coaic/Minimal-UART-Computer-3/(list of files, drawings)

Other design files:
KiCAD10/8-Bit CPU 32k.dsn
