coaic/Minimal-UART-Computer-3/KiCAD10/8-Bit CPU 32k.kicad_pcb

## KiCad design KiCAD10/8-Bit CPU 32k.kicad_pcb (2026-06-27)

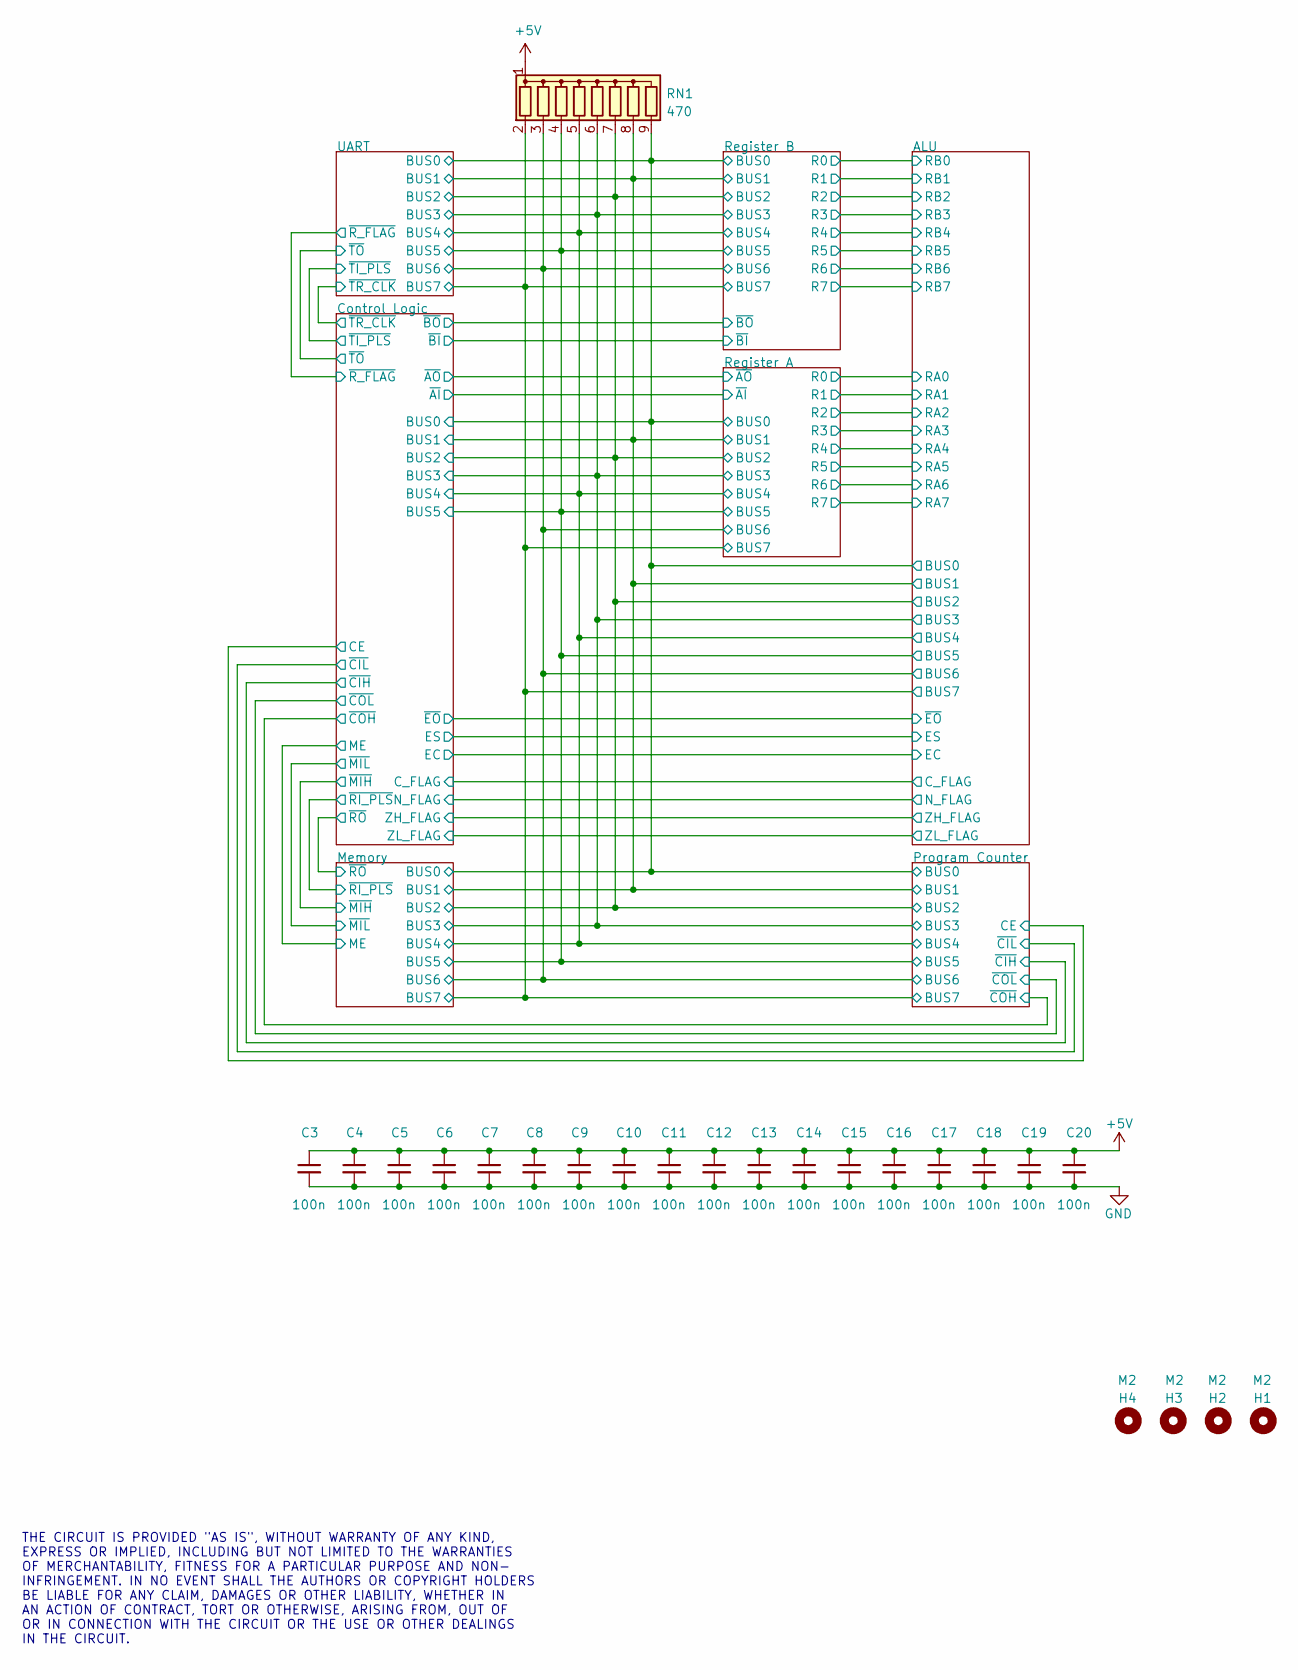
[picture p1: schematic 8-Bit CPU 32k.kicad_sch, Minimal UART Computer 3]

Parts:
C3, C4, C5, C6, C7, C8, C9, C10, C11, C12, C13, C14, C15, C16, C17, C18, C19, C20: 100n; C_Disc_D3.0mm_W2.0mm_P2.50mm
H1, H2, H3, H4: M2; MountingHole_2.2mm_M2
RN1: 470; R_Array_SIP9

Connections:
+5V: C3.1, C4.1, C5.1, C6.1, C7.1, C8.1, C9.1, C10.1, C11.1, C12.1, C13.1, C14.1, C15.1, C16.1, C17.1, C18.1, C19.1, C20.1, RN1.1 (common); also elsewhere on the board
/ALU/BUS0: RN1.9 (R8); also elsewhere on the board
/ALU/BUS1: RN1.8 (R7); also elsewhere on the board
/ALU/BUS2: RN1.7 (R6); also elsewhere on the board
/ALU/BUS3: RN1.6 (R5); also elsewhere on the board
/ALU/BUS4: RN1.5 (R4); also elsewhere on the board
/ALU/BUS5: RN1.4 (R3); also elsewhere on the board
/ALU/BUS6: RN1.3 (R2); also elsewhere on the board
/ALU/BUS7: RN1.2 (R1); also elsewhere on the board
GND: C3.2, C4.2, C5.2, C6.2, C7.2, C8.2, C9.2, C10.2, C11.2, C12.2, C13.2, C14.2, C15.2, C16.2, C17.2, C18.2, C19.2, C20.2; also elsewhere on the board

Notes on the sheet:
THE CIRCUIT IS PROVIDED "AS IS", WITHOUT WARRANTY OF ANY KIND, EXPRESS OR IMPLIED, INCLUDING BUT NOT LIMITED TO THE WARRANTIES OF MERCHANTABILITY, FITNESS FOR A PARTICULAR PURPOSE AND NON- INFRINGEMENT. IN NO EVENT SHALL THE AUTHORS OR COPYRIGHT HOLDERS BE LIABLE FOR ANY CLAIM, DAMAGES OR OTHER LIA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

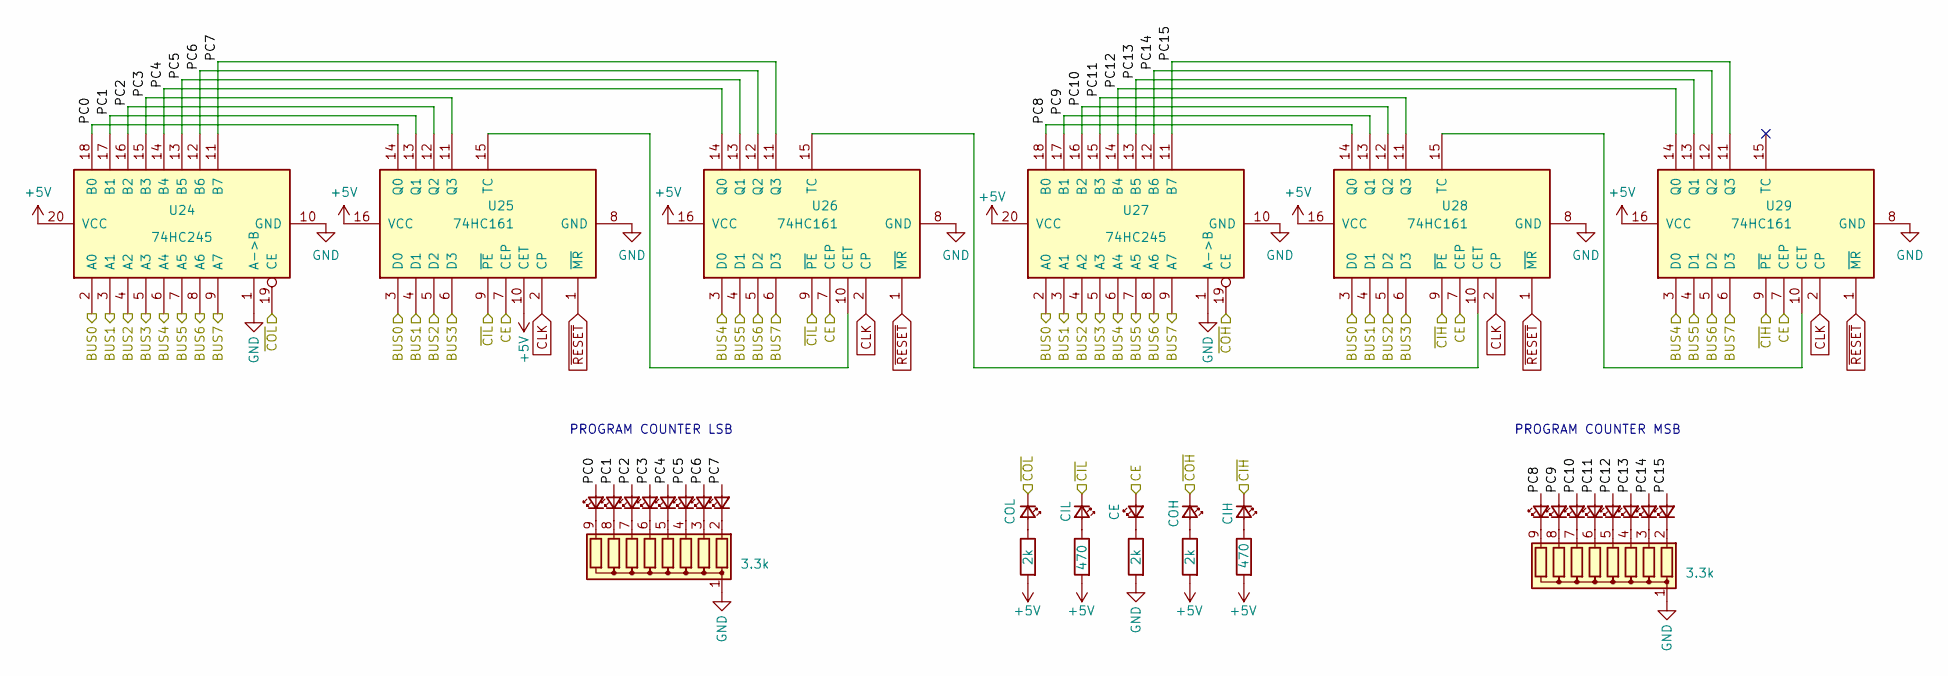
[picture p2: schematic PC.kicad_sch, Program Counter]

Parts:
D20, D21, D22, D23, D24, D25, D26, D27, D28, D29, D30, D31, D32, D33, D34, D35: LED_Small; LED_D5.0mm
D79: CIH; LED_D5.0mm
D81: COH; LED_D5.0mm
D83: COL; LED_D5.0mm
D84: CIL; LED_D5.0mm
D92: CE; LED_D5.0mm
R12, R17: 470; R_Axial_DIN0207_L6.3mm_D2.5mm_P7.62mm_Horizontal
R14, R16, R25: 2k; R_Axial_DIN0207_L6.3mm_D2.5mm_P7.62mm_Horizontal
RN4, RN5: 3.3k; R_Array_SIP9
U24, U27: 74HC245; DIP-20_W7.62mm
U25, U26, U28, U29: 74HC161; DIP-16_W7.62mm

Connections:
+5V: R12.2, R14.2, R16.2, R17.2, U24.20 (VCC), U25.10 (CET), U25.16 (VCC), U26.16 (VCC), U27.20 (VCC), U28.16 (VCC), U29.16 (VCC); also elsewhere on the board
/ALU/BUS0: U24.2 (A0), U25.3 (D0), U27.2 (A0), U28.3 (D0); also elsewhere on the board
/ALU/BUS1: U24.3 (A1), U25.4 (D1), U27.3 (A1), U28.4 (D1); also elsewhere on the board
/ALU/BUS2: U24.4 (A2), U25.5 (D2), U27.4 (A2), U28.5 (D2); also elsewhere on the board
/ALU/BUS3: U24.5 (A3), U25.6 (D3), U27.5 (A3), U28.6 (D3); also elsewhere on the board
/ALU/BUS4: U24.6 (A4), U26.3 (D0), U27.6 (A4), U29.3 (D0); also elsewhere on the board
/ALU/BUS5: U24.7 (A5), U26.4 (D1), U27.7 (A5), U29.4 (D1); also elsewhere on the board
/ALU/BUS6: U24.8 (A6), U26.5 (D2), U27.8 (A6), U29.5 (D2); also elsewhere on the board
/ALU/BUS7: U24.9 (A7), U26.6 (D3), U27.9 (A7), U29.6 (D3); also elsewhere on the board
/Control Logic/CE: D92.2 (A), U25.7 (CEP), U26.7 (CEP), U28.7 (CEP), U29.7 (CEP); also elsewhere on the board
/Control Logic/~CIH: D79.1 (K), U28.9 (~PE), U29.9 (~PE); also elsewhere on the board
/Control Logic/~CIL: D84.1 (K), U25.9 (~PE), U26.9 (~PE); also elsewhere on the board
/Control Logic/~COH: D81.1 (K), U27.19 (CE); also elsewhere on the board
/Control Logic/~COL: D83.1 (K), U24.19 (CE); also elsewhere on the board
/Program Counter/PC0: D20.2 (A), U24.18 (B0), U25.14 (Q0)
/Program Counter/PC1: D21.2 (A), U24.17 (B1), U25.13 (Q1)
/Program Counter/PC2: D22.2 (A), U24.16 (B2), U25.12 (Q2)
/Program Counter/PC3: D23.2 (A), U24.15 (B3), U25.11 (Q3)
/Program Counter/PC4: D24.2 (A), U24.14 (B4), U26.14 (Q0)
/Program Counter/PC5: D25.2 (A), U24.13 (B5), U26.13 (Q1)
/Program Counter/PC6: D26.2 (A), U24.12 (B6), U26.12 (Q2)
/Program Counter/PC7: D27.2 (A), U24.11 (B7), U26.11 (Q3)
/Program Counter/PC8: D28.2 (A), U27.18 (B0), U28.14 (Q0)
/Program Counter/PC9: D29.2 (A), U27.17 (B1), U28.13 (Q1)
/Program Counter/PC10: D30.2 (A), U27.16 (B2), U28.12 (Q2)
/Program Counter/PC11: D31.2 (A), U27.15 (B3), U28.11 (Q3)
/Program Counter/PC12: D32.2 (A), U27.14 (B4), U29.14 (Q0)
/Program Counter/PC13: D33.2 (A), U27.13 (B5), U29.13 (Q1)
/Program Counter/PC14: D34.2 (A), U27.12 (B6), U29.12 (Q2)
/Program Counter/PC15: D35.2 (A), U27.11 (B7), U29.11 (Q3)
CLK: U25.2 (CP), U26.2 (CP), U28.2 (CP), U29.2 (CP); also elsewhere on the board
GND: R25.2, RN4.1 (common), RN5.1 (common), U24.1 (A->B), U24.10 (GND), U25.8 (GND), U26.8 (GND), U27.1 (A->B), U27.10 (GND), U28.8 (GND), U29.8 (GND); also elsewhere on the board
unnamed: D20.1 (K), RN4.9 (R8)
unnamed: D21.1 (K), RN4.8 (R7)
unnamed: D22.1 (K), RN4.7 (R6)
unnamed: D23.1 (K), RN4.6 (R5)
unnamed: D24.1 (K), RN4.5 (R4)
unnamed: D25.1 (K), RN4.4 (R3)
unnamed: D26.1 (K), RN4.3 (R2)
unnamed: D27.1 (K), RN4.2 (R1)
unnamed: D28.1 (K), RN5.9 (R8)
unnamed: D29.1 (K), RN5.8 (R7)
unnamed: D30.1 (K), RN5.7 (R6)
unnamed: D31.1 (K), RN5.6 (R5)
unnamed: D32.1 (K), RN5.5 (R4)
unnamed: D33.1 (K), RN5.4 (R3)
unnamed: D34.1 (K), RN5.3 (R2)
unnamed: D35.1 (K), RN5.2 (R1)
unnamed: D79.2 (A), R12.1
unnamed: D81.2 (A), R14.1
unnamed: D83.2 (A), R16.1
unnamed: D84.2 (A), R17.1
unnamed: D92.1 (K), R25.1
unnamed: U25.15 (TC), U26.10 (CET)
unnamed: U26.15 (TC), U28.10 (CET)
unnamed: U28.15 (TC), U29.10 (CET)
~RESET: U25.1 (~MR), U26.1 (~MR), U28.1 (~MR), U29.1 (~MR); also elsewhere on the board

Notes on the sheet:
PROGRAM COUNTER MSB
PROGRAM COUNTER LSB

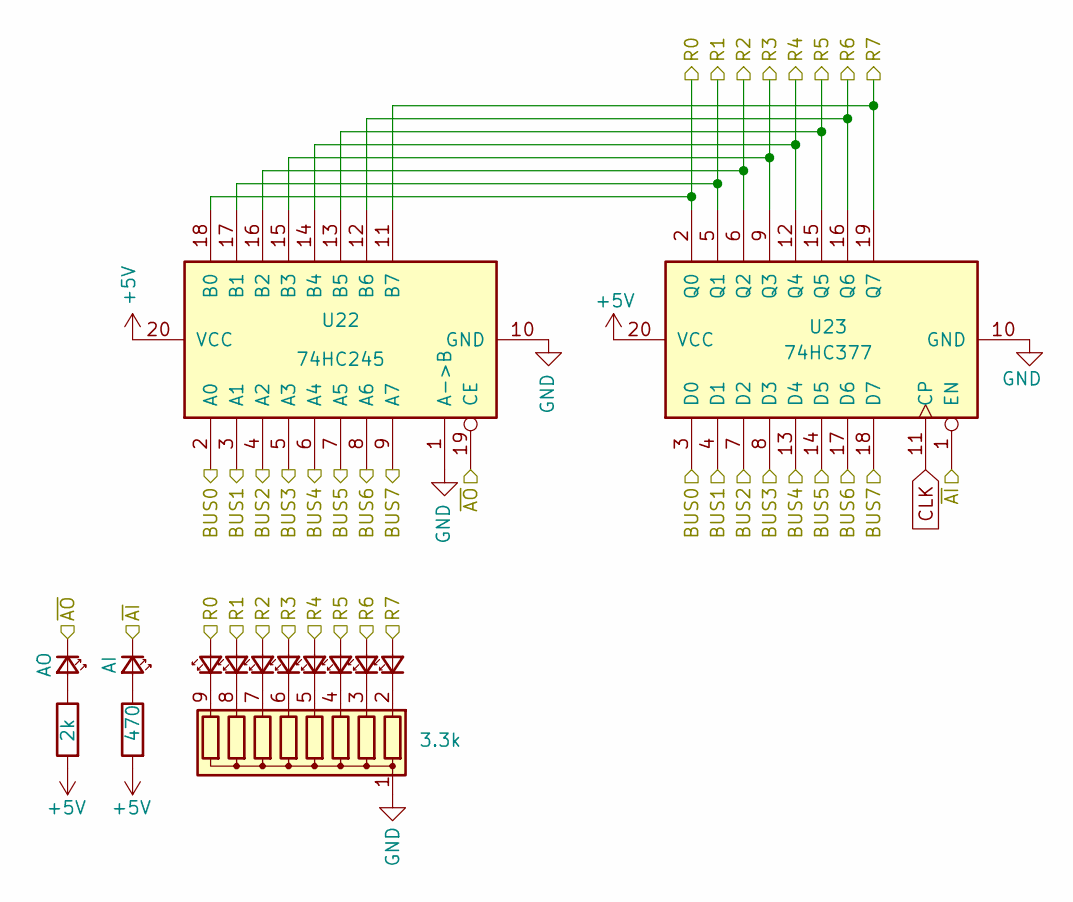
[picture p3: schematic RegA.kicad_sch, A Register]

Parts:
D36, D37, D38, D39, D40, D41, D42, D43: LED_Small; LED_D5.0mm
D65: AI; LED_D5.0mm
D66: AO; LED_D5.0mm
R7: 470; R_Axial_DIN0207_L6.3mm_D2.5mm_P7.62mm_Horizontal
R8: 2k; R_Axial_DIN0207_L6.3mm_D2.5mm_P7.62mm_Horizontal
RN6: 3.3k; R_Array_SIP9
U22: 74HC245; DIP-20_W7.62mm
U23: 74HC377; DIP-20_W7.62mm

Connections:
+5V: R7.2, R8.2, U22.20 (VCC), U23.20 (VCC); also elsewhere on the board
/ALU/BUS0: U22.2 (A0), U23.3 (D0); also elsewhere on the board
/ALU/BUS1: U22.3 (A1), U23.4 (D1); also elsewhere on the board
/ALU/BUS2: U22.4 (A2), U23.7 (D2); also elsewhere on the board
/ALU/BUS3: U22.5 (A3), U23.8 (D3); also elsewhere on the board
/ALU/BUS4: U22.6 (A4), U23.13 (D4); also elsewhere on the board
/ALU/BUS5: U22.7 (A5), U23.14 (D5); also elsewhere on the board
/ALU/BUS6: U22.8 (A6), U23.17 (D6); also elsewhere on the board
/ALU/BUS7: U22.9 (A7), U23.18 (D7); also elsewhere on the board
/ALU/RA0: D36.2 (A), U22.18 (B0), U23.2 (Q0); also elsewhere on the board
/ALU/RA1: D37.2 (A), U22.17 (B1), U23.5 (Q1); also elsewhere on the board
/ALU/RA2: D38.2 (A), U22.16 (B2), U23.6 (Q2); also elsewhere on the board
/ALU/RA3: D39.2 (A), U22.15 (B3), U23.9 (Q3); also elsewhere on the board
/ALU/RA4: D40.2 (A), U22.14 (B4), U23.12 (Q4); also elsewhere on the board
/ALU/RA5: D41.2 (A), U22.13 (B5), U23.15 (Q5); also elsewhere on the board
/ALU/RA6: D42.2 (A), U22.12 (B6), U23.16 (Q6); also elsewhere on the board
/ALU/RA7: D43.2 (A), U22.11 (B7), U23.19 (Q7); also elsewhere on the board
/Control Logic/~AI: D65.1 (K), U23.1 (EN); also elsewhere on the board
/Control Logic/~AO: D66.1 (K), U22.19 (CE); also elsewhere on the board
CLK: U23.11 (CP); also elsewhere on the board
GND: RN6.1 (common), U22.1 (A->B), U22.10 (GND), U23.10 (GND); also elsewhere on the board
unnamed: D36.1 (K), RN6.9 (R8)
unnamed: D37.1 (K), RN6.8 (R7)
unnamed: D38.1 (K), RN6.7 (R6)
unnamed: D39.1 (K), RN6.6 (R5)
unnamed: D40.1 (K), RN6.5 (R4)
unnamed: D41.1 (K), RN6.4 (R3)
unnamed: D42.1 (K), RN6.3 (R2)
unnamed: D43.1 (K), RN6.2 (R1)
unnamed: D65.2 (A), R7.1
unnamed: D66.2 (A), R8.1

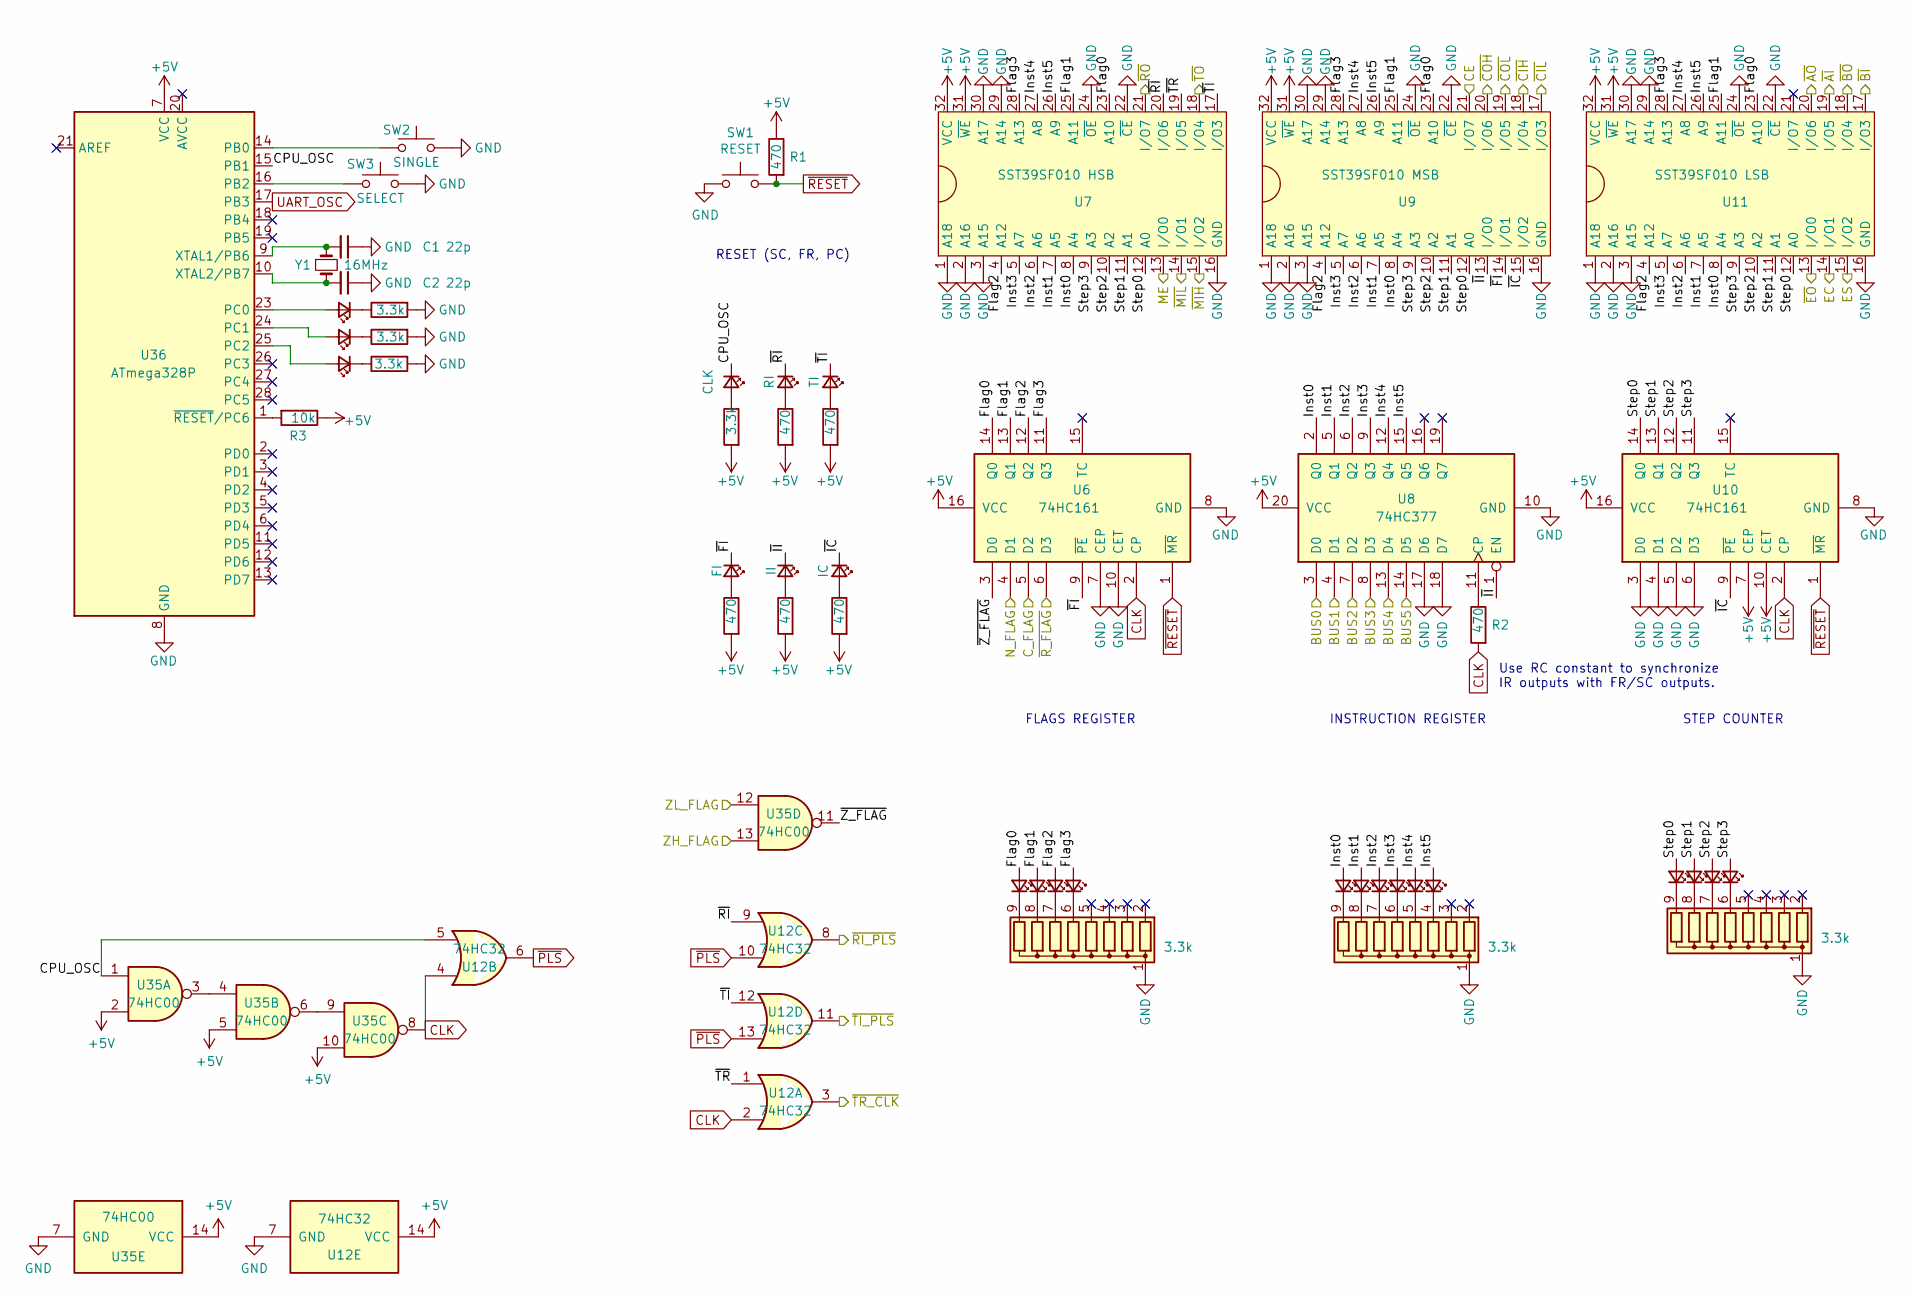
[picture p4: schematic IR.kicad_sch, Control Logic]

Parts:
C1, C2: 22p; C_Disc_D5.0mm_W2.5mm_P2.50mm
D1, D2, D3: LED_small; LED_D5.0mm
D60, D61, D62, D63, D64, D67, D68, D69, D70, D71, D72, D73, D74, D75: LED_Small; LED_D5.0mm
D82: RI; LED_D5.0mm
D87: TI; LED_D5.0mm
D89: FI; LED_D5.0mm
D90: II; LED_D5.0mm
D91: IC; LED_D5.0mm
D100: CLK; LED_D5.0mm
R1, R2, R15, R20, R22, R23, R24: 470; R_Axial_DIN0207_L6.3mm_D2.5mm_P7.62mm_Horizontal
R3: 10k; R_Axial_DIN0207_L6.3mm_D2.5mm_P7.62mm_Horizontal
R4, R5, R6, R33: 3.3k; R_Axial_DIN0207_L6.3mm_D2.5mm_P7.62mm_Horizontal
RN9, RN10, RN11: 3.3k; R_Array_SIP9
SW1: RESET; SW_PUSH_6mm
SW2: SINGLE; SW_PUSH_6mm
SW3: SELECT; SW_PUSH_6mm
U6, U10: 74HC161; DIP-16_W7.62mm
U7: SST39SF010 HSB; DIP-32_W15.24mm
U8: 74HC377; DIP-20_W7.62mm
U9: SST39SF010 MSB; DIP-32_W15.24mm
U11: SST39SF010 LSB; DIP-32_W15.24mm
U12: 74HC32; DIP-14_W7.62mm
U35: 74HC00; DIP-14_W7.62mm
U36: ATmega328P; DIP-28_W7.62mm
Y1: 16MHz; Crystal_HC18-U_Vertical

Connections:
+5V: R1.1, R3.1, R15.2, R20.2, R22.2, R23.2, R24.2, R33.2, U6.16 (VCC), U7.31 (~WE), U7.32 (VCC), U8.20 (VCC), U9.31 (~WE), U9.32 (VCC), U10.7 (CEP), U10.10 (CET), U10.16 (VCC), U11.31 (~WE), U11.32 (VCC), U12.14 (VCC), U35.2, U35.5, U35.10, U35.14 (VCC), U36.7 (VCC); also elsewhere on the board
/ALU/BUS0: U8.3 (D0); also elsewhere on the board
/ALU/BUS1: U8.4 (D1); also elsewhere on the board
/ALU/BUS2: U8.7 (D2); also elsewhere on the board
/ALU/BUS3: U8.8 (D3); also elsewhere on the board
/ALU/BUS4: U8.13 (D4); also elsewhere on the board
/ALU/BUS5: U8.14 (D5); also elsewhere on the board
/ALU/C_FLAG: U6.5 (D2); also elsewhere on the board
/ALU/EC: U11.14 (I/O1); also elsewhere on the board
/ALU/ES: U11.15 (I/O2); also elsewhere on the board
/ALU/N_FLAG: U6.4 (D1); also elsewhere on the board
/ALU/ZH_FLAG: U35.13; also elsewhere on the board
/ALU/ZL_FLAG: U35.12; also elsewhere on the board
/ALU/~EO: U11.13 (I/O0); also elsewhere on the board
/Control Logic/CE: U9.21 (I/O7); also elsewhere on the board
/Control Logic/CPU_OSC: D100.1 (K), U12.5, U35.1, U36.15 (PB1)
/Control Logic/Flag0: D71.2 (A), U6.14 (Q0), U7.23 (A10), U9.23 (A10), U11.23 (A10)
/Control Logic/Flag1: D70.2 (A), U6.13 (Q1), U7.25 (A11), U9.25 (A11), U11.25 (A11)
/Control Logic/Flag2: D69.2 (A), U6.12 (Q2), U7.4 (A12), U9.4 (A12), U11.4 (A12)
/Control Logic/Flag3: D68.2 (A), U6.11 (Q3), U7.28 (A13), U9.28 (A13), U11.28 (A13)
/Control Logic/Inst0: D63.2 (A), U7.8 (A4), U8.2 (Q0), U9.8 (A4), U11.8 (A4)
/Control Logic/Inst1: D62.2 (A), U7.7 (A5), U8.5 (Q1), U9.7 (A5), U11.7 (A5)
/Control Logic/Inst2: D61.2 (A), U7.6 (A6), U8.6 (Q2), U9.6 (A6), U11.6 (A6)
/Control Logic/Inst3: D60.2 (A), U7.5 (A7), U8.9 (Q3), U9.5 (A7), U11.5 (A7)
/Control Logic/Inst4: D64.2 (A), U7.27 (A8), U8.12 (Q4), U9.27 (A8), U11.27 (A8)
/Control Logic/Inst5: D67.2 (A), U7.26 (A9), U8.15 (Q5), U9.26 (A9), U11.26 (A9)
/Control Logic/ME: U7.13 (I/O0); also elsewhere on the board
/Control Logic/Step0: D75.2 (A), U7.12 (A0), U9.12 (A0), U10.14 (Q0), U11.12 (A0)
/Control Logic/Step1: D74.2 (A), U7.11 (A1), U9.11 (A1), U10.13 (Q1), U11.11 (A1)
/Control Logic/Step2: D73.2 (A), U7.10 (A2), U9.10 (A2), U10.12 (Q2), U11.10 (A2)
/Control Logic/Step3: D72.2 (A), U7.9 (A3), U9.9 (A3), U10.11 (Q3), U11.9 (A3)
/Control Logic/~AI: U11.19 (I/O5); also elsewhere on the board
/Control Logic/~AO: U11.20 (I/O6); also elsewhere on the board
/Control Logic/~BI: U11.17 (I/O3); also elsewhere on the board
/Control Logic/~BO: U11.18 (I/O4); also elsewhere on the board
/Control Logic/~CIH: U9.18 (I/O4); also elsewhere on the board
/Control Logic/~CIL: U9.17 (I/O3); also elsewhere on the board
/Control Logic/~COH: U9.20 (I/O6); also elsewhere on the board
/Control Logic/~COL: U9.19 (I/O5); also elsewhere on the board
/Control Logic/~FI: D89.1 (K), U6.9 (~PE), U9.14 (I/O1)
/Control Logic/~IC: D91.1 (K), U9.15 (I/O2), U10.9 (~PE)
/Control Logic/~II: D90.1 (K), U8.1 (EN), U9.13 (I/O0)
/Control Logic/~MIH: U7.15 (I/O2); also elsewhere on the board
/Control Logic/~MIL: U7.14 (I/O1); also elsewhere on the board
/Control Logic/~RI_PLS: U12.8; also elsewhere on the board
/Control Logic/~RI: D82.1 (K), U7.20 (I/O6), U12.9
/Control Logic/~RO: U7.21 (I/O7); also elsewhere on the board
/Control Logic/~R_FLAG: U6.6 (D3); also elsewhere on the board
/Control Logic/~TI_PLS: U12.11; also elsewhere on the board
/Control Logic/~TI: D87.1 (K), U7.17 (I/O3), U12.12
/Control Logic/~TO: U7.18 (I/O4); also elsewhere on the board
/Control Logic/~TR_PLS: U12.3; also elsewhere on the board
/Control Logic/~TR: U7.19 (I/O5), U12.1
/Control Logic/~Z_FLAG: U6.3 (D0), U35.11
CLK: R2.2, U6.2 (CP), U10.2 (CP), U12.2, U12.4, U35.8; also elsewhere on the board
GND: C1.1, C2.1, R4.2, R5.2, R6.2, RN9.1 (common), RN10.1 (common), RN11.1 (common), SW1.2, SW2.1, SW3.1, U6.7 (CEP), U6.8 (GND), U6.10 (CET), U7.1 (A18), U7.2 (A16), U7.3 (A15), U7.16 (GND), U7.22 (~CE), U7.24 (~OE), U7.29 (A14), U7.30 (A17), U8.10 (GND), U8.17 (D6), U8.18 (D7), U9.1 (A18), U9.2 (A16), U9.3 (A15), U9.16 (GND), U9.22 (~CE), U9.24 (~OE), U9.29 (A14), U9.30 (A17), U10.3 (D0), U10.4 (D1), U10.5 (D2), U10.6 (D3), U10.8 (GND), U11.1 (A18), U11.2 (A16), U11.3 (A15), U11.16 (GND), U11.22 (~CE), U11.24 (~OE), U11.29 (A14), U11.30 (A17), U12.7 (GND), U35.7 (GND), U36.8 (GND), U36.22 (GND); also elsewhere on the board
unnamed: D1.2 (A), U36.25 (PC2)
unnamed: D1.1 (K), R4.1
unnamed: D2.2 (A), U36.24 (PC1)
unnamed: D2.1 (K), R5.1
unnamed: D3.2 (A), U36.23 (PC0)
unnamed: D3.1 (K), R6.1
unnamed: D60.1 (K), RN9.6 (R5)
unnamed: D61.1 (K), RN9.7 (R6)
unnamed: D62.1 (K), RN9.8 (R7)
unnamed: D63.1 (K), RN9.9 (R8)
unnamed: D64.1 (K), RN9.5 (R4)
unnamed: D67.1 (K), RN9.4 (R3)
unnamed: D68.1 (K), RN11.6 (R5)
unnamed: D69.1 (K), RN11.7 (R6)
unnamed: D70.1 (K), RN11.8 (R7)
unnamed: D71.1 (K), RN11.9 (R8)
unnamed: D72.1 (K), RN10.6 (R5)
unnamed: D73.1 (K), RN10.7 (R6)
unnamed: D74.1 (K), RN10.8 (R7)
unnamed: D75.1 (K), RN10.9 (R8)
unnamed: D82.2 (A), R15.1
unnamed: D87.2 (A), R20.1
unnamed: D89.2 (A), R22.1
unnamed: D90.2 (A), R23.1
unnamed: D91.2 (A), R24.1
unnamed: D100.2 (A), R33.1
unnamed: R2.1, U8.11 (CP)
unnamed: U35.3, U35.4
unnamed: U35.6, U35.9
unnamed: SW2.2, U36.14 (PB0)
unnamed: SW3.2, U36.16 (PB2)
unnamed: C1.2, U36.9 (XTAL1/PB6), Y1.1
unnamed: C2.2, U36.10 (XTAL2/PB7), Y1.2
unnamed: R3.2, U36.1 (~RESET/PC6)
UART_OSC: U36.17 (PB3); also elsewhere on the board
~PLS: U12.6, U12.10, U12.13; also elsewhere on the board
~RESET: R1.2, SW1.1, U6.1 (~MR), U10.1 (~MR); also elsewhere on the board

Notes on the sheet:
INSTRUCTION REGISTER
RESET (SC, FR, PC)
STEP COUNTER
FLAGS REGISTER
Use RC constant to synchronize IR outputs with FR/SC outputs.

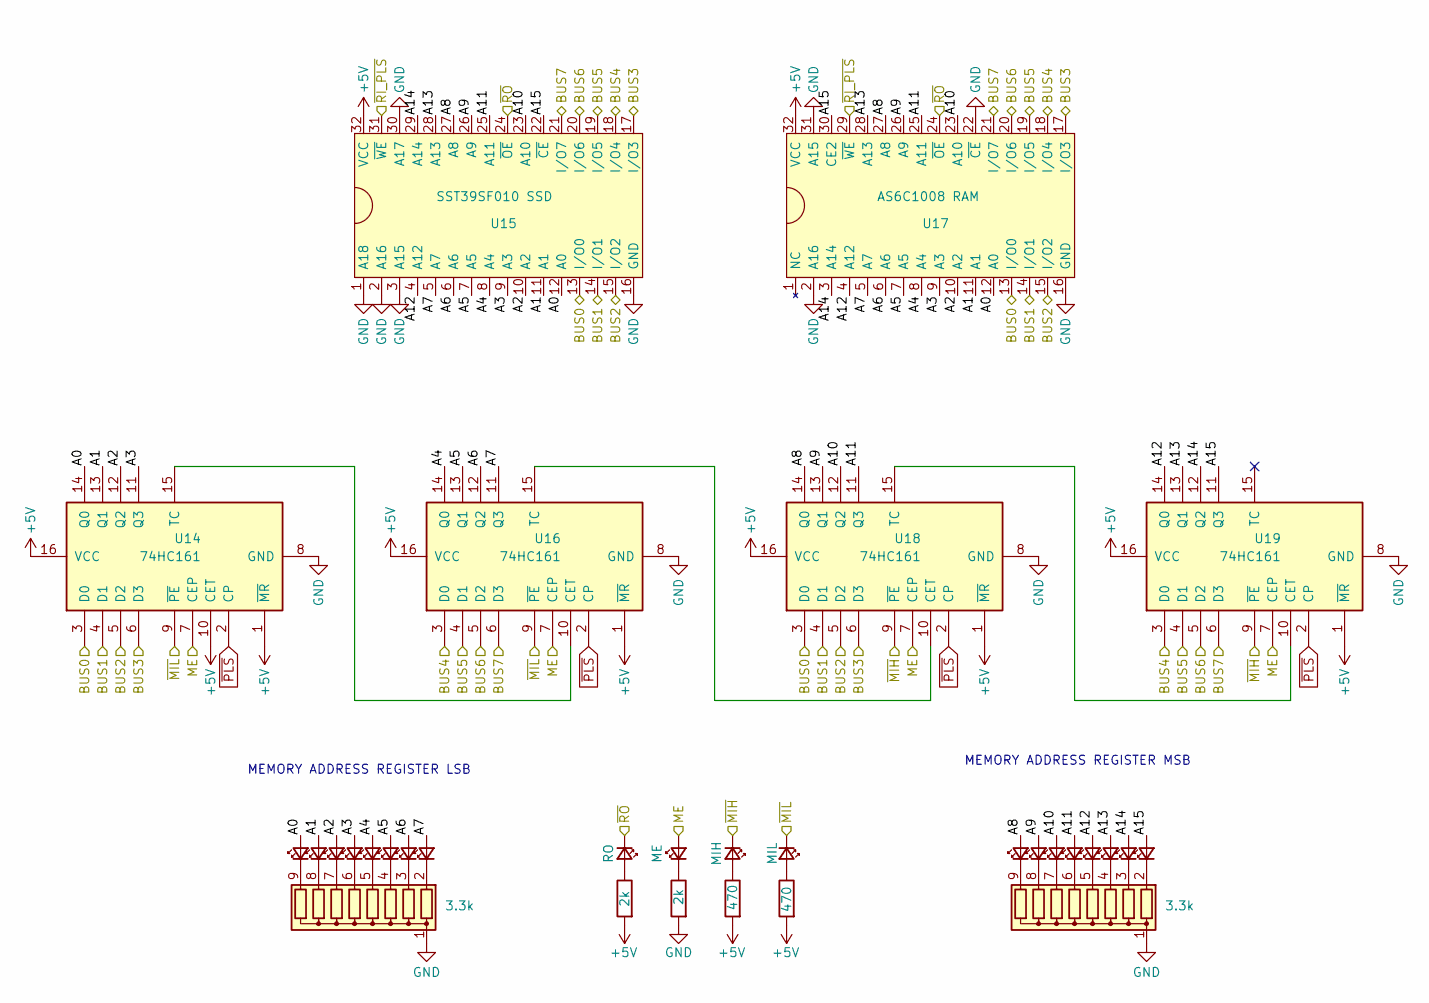
[picture p5: schematic RAM.kicad_sch, RAM, ROM and MAR]

Parts:
D4, D5, D6, D7, D8, D9, D10, D11, D12, D13, D14, D15, D16, D17, D18, D19: LED_Small; LED_D5.0mm
D85: MIL; LED_D5.0mm
D86: MIH; LED_D5.0mm
D88: ME; LED_D5.0mm
D99: RO; LED_D5.0mm
R18, R19: 470; R_Axial_DIN0207_L6.3mm_D2.5mm_P7.62mm_Horizontal
R21, R32: 2k; R_Axial_DIN0207_L6.3mm_D2.5mm_P7.62mm_Horizontal
RN2, RN3: 3.3k; R_Array_SIP9
U14, U16, U18, U19: 74HC161; DIP-16_W7.62mm
U15: SST39SF010 SSD; DIP-32_W15.24mm
U17: AS6C1008 RAM; DIP-32_W15.24mm

Connections:
+5V: R18.2, R19.2, R32.2, U14.1 (~MR), U14.10 (CET), U14.16 (VCC), U15.32 (VCC), U16.1 (~MR), U16.16 (VCC), U17.32 (VCC), U18.1 (~MR), U18.16 (VCC), U19.1 (~MR), U19.16 (VCC); also elsewhere on the board
/ALU/BUS0: U14.3 (D0), U15.13 (I/O0), U17.13 (I/O0), U18.3 (D0); also elsewhere on the board
/ALU/BUS1: U14.4 (D1), U15.14 (I/O1), U17.14 (I/O1), U18.4 (D1); also elsewhere on the board
/ALU/BUS2: U14.5 (D2), U15.15 (I/O2), U17.15 (I/O2), U18.5 (D2); also elsewhere on the board
/ALU/BUS3: U14.6 (D3), U15.17 (I/O3), U17.17 (I/O3), U18.6 (D3); also elsewhere on the board
/ALU/BUS4: U15.18 (I/O4), U16.3 (D0), U17.18 (I/O4), U19.3 (D0); also elsewhere on the board
/ALU/BUS5: U15.19 (I/O5), U16.4 (D1), U17.19 (I/O5), U19.4 (D1); also elsewhere on the board
/ALU/BUS6: U15.20 (I/O6), U16.5 (D2), U17.20 (I/O6), U19.5 (D2); also elsewhere on the board
/ALU/BUS7: U15.21 (I/O7), U16.6 (D3), U17.21 (I/O7), U19.6 (D3); also elsewhere on the board
/Control Logic/ME: D88.2 (A), U14.7 (CEP), U16.7 (CEP), U18.7 (CEP), U19.7 (CEP); also elsewhere on the board
/Control Logic/~MIH: D86.1 (K), U18.9 (~PE), U19.9 (~PE); also elsewhere on the board
/Control Logic/~MIL: D85.1 (K), U14.9 (~PE), U16.9 (~PE); also elsewhere on the board
/Control Logic/~RI_PLS: U15.31 (~WE), U17.29 (~WE); also elsewhere on the board
/Control Logic/~RO: D99.1 (K), U15.24 (~OE), U17.24 (~OE); also elsewhere on the board
/Memory/A0: D7.2 (A), U14.14 (Q0), U15.12 (A0), U17.12 (A0)
/Memory/A1: D6.2 (A), U14.13 (Q1), U15.11 (A1), U17.11 (A1)
/Memory/A2: D5.2 (A), U14.12 (Q2), U15.10 (A2), U17.10 (A2)
/Memory/A3: D4.2 (A), U14.11 (Q3), U15.9 (A3), U17.9 (A3)
/Memory/A4: D11.2 (A), U15.8 (A4), U16.14 (Q0), U17.8 (A4)
/Memory/A5: D10.2 (A), U15.7 (A5), U16.13 (Q1), U17.7 (A5)
/Memory/A6: D9.2 (A), U15.6 (A6), U16.12 (Q2), U17.6 (A6)
/Memory/A7: D8.2 (A), U15.5 (A7), U16.11 (Q3), U17.5 (A7)
/Memory/A8: D12.2 (A), U15.27 (A8), U17.27 (A8), U18.14 (Q0)
/Memory/A9: D13.2 (A), U15.26 (A9), U17.26 (A9), U18.13 (Q1)
/Memory/A10: D14.2 (A), U15.23 (A10), U17.23 (A10), U18.12 (Q2)
/Memory/A11: D15.2 (A), U15.25 (A11), U17.25 (A11), U18.11 (Q3)
/Memory/A12: D16.2 (A), U15.4 (A12), U17.4 (A12), U19.14 (Q0)
/Memory/A13: D17.2 (A), U15.28 (A13), U17.28 (A13), U19.13 (Q1)
/Memory/A14: D18.2 (A), U15.29 (A14), U17.3 (A14), U19.12 (Q2)
/Memory/A15: D19.2 (A), U15.22 (~CE), U17.30 (CE2), U19.11 (Q3)
GND: R21.2, RN2.1 (common), RN3.1 (common), U14.8 (GND), U15.1 (A18), U15.2 (A16), U15.3 (A15), U15.16 (GND), U15.30 (A17), U16.8 (GND), U17.2 (A16), U17.16 (GND), U17.22 (~CE), U17.31 (A15), U18.8 (GND), U19.8 (GND); also elsewhere on the board
unnamed: D4.1 (K), RN2.6 (R5)
unnamed: D5.1 (K), RN2.7 (R6)
unnamed: D6.1 (K), RN2.8 (R7)
unnamed: D7.1 (K), RN2.9 (R8)
unnamed: D8.1 (K), RN2.2 (R1)
unnamed: D9.1 (K), RN2.3 (R2)
unnamed: D10.1 (K), RN2.4 (R3)
unnamed: D11.1 (K), RN2.5 (R4)
unnamed: D12.1 (K), RN3.9 (R8)
unnamed: D13.1 (K), RN3.8 (R7)
unnamed: D14.1 (K), RN3.7 (R6)
unnamed: D15.1 (K), RN3.6 (R5)
unnamed: D16.1 (K), RN3.5 (R4)
unnamed: D17.1 (K), RN3.4 (R3)
unnamed: D18.1 (K), RN3.3 (R2)
unnamed: D19.1 (K), RN3.2 (R1)
unnamed: D85.2 (A), R18.1
unnamed: D86.2 (A), R19.1
unnamed: D88.1 (K), R21.1
unnamed: D99.2 (A), R32.1
unnamed: U14.15 (TC), U16.10 (CET)
unnamed: U16.15 (TC), U18.10 (CET)
unnamed: U18.15 (TC), U19.10 (CET)
~PLS: U14.2 (CP), U16.2 (CP), U18.2 (CP), U19.2 (CP); also elsewhere on the board

Notes on the sheet:
MEMORY ADDRESS REGISTER LSB
MEMORY ADDRESS REGISTER MSB

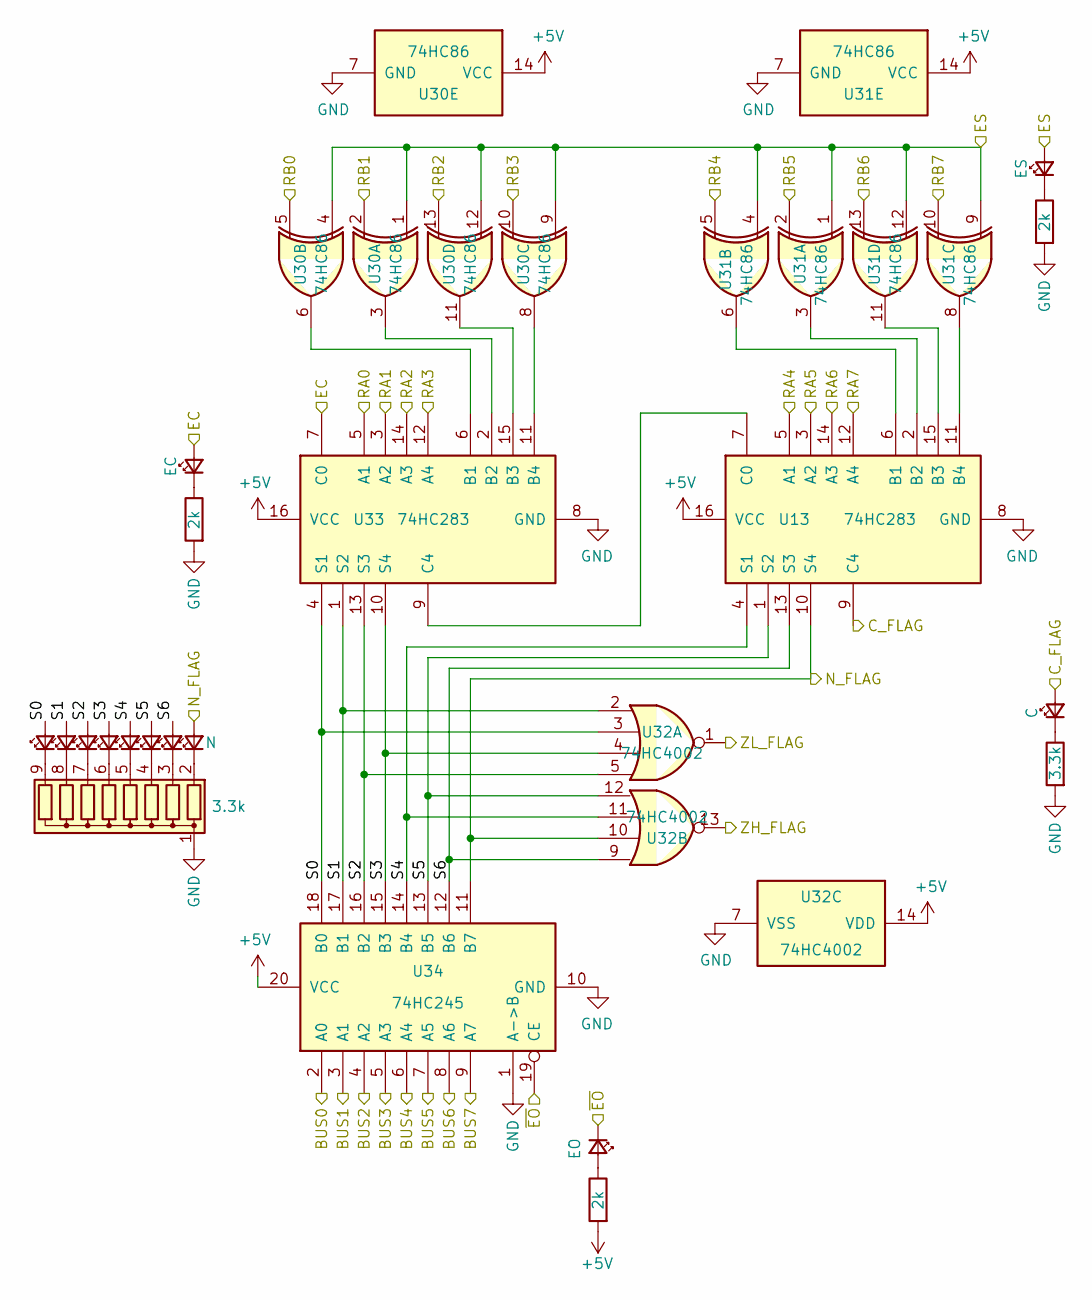
[picture p6: schematic ALU.kicad_sch, Arithmetic Unit]

Parts:
D52, D53, D54, D55, D56, D57, D58: LED_Small; LED_D5.0mm
D59: N; LED_D5.0mm
D78: EO; LED_D5.0mm
D93: EC; LED_D5.0mm
D94: ES; LED_D5.0mm
D95: C; LED_D5.0mm
R11, R26, R27: 2k; R_Axial_DIN0207_L6.3mm_D2.5mm_P7.62mm_Horizontal
R28: 3.3k; R_Axial_DIN0207_L6.3mm_D2.5mm_P7.62mm_Horizontal
RN8: 3.3k; R_Array_SIP9
U13, U33: 74HC283; DIP-16_W7.62mm
U30, U31: 74HC86; DIP-14_W7.62mm
U32: 74HC4002; DIP-14_W7.62mm
U34: 74HC245; DIP-20_W7.62mm

Connections:
+5V: R11.2, U13.16 (VCC), U30.14 (VCC), U31.14 (VCC), U32.14 (VDD), U33.16 (VCC), U34.20 (VCC); also elsewhere on the board
/ALU/BUS0: U34.2 (A0); also elsewhere on the board
/ALU/BUS1: U34.3 (A1); also elsewhere on the board
/ALU/BUS2: U34.4 (A2); also elsewhere on the board
/ALU/BUS3: U34.5 (A3); also elsewhere on the board
/ALU/BUS4: U34.6 (A4); also elsewhere on the board
/ALU/BUS5: U34.7 (A5); also elsewhere on the board
/ALU/BUS6: U34.8 (A6); also elsewhere on the board
/ALU/BUS7: U34.9 (A7); also elsewhere on the board
/ALU/C_FLAG: D95.2 (A), U13.9 (C4); also elsewhere on the board
/ALU/EC: D93.2 (A), U33.7 (C0); also elsewhere on the board
/ALU/ES: D94.2 (A), U30.1, U30.4, U30.9, U30.12, U31.1, U31.4, U31.9, U31.12; also elsewhere on the board
/ALU/N_FLAG: D59.2 (A), U13.10 (S4), U32.10, U34.11 (B7); also elsewhere on the board
/ALU/RA0: U33.5 (A1); also elsewhere on the board
/ALU/RA1: U33.3 (A2); also elsewhere on the board
/ALU/RA2: U33.14 (A3); also elsewhere on the board
/ALU/RA3: U33.12 (A4); also elsewhere on the board
/ALU/RA4: U13.5 (A1); also elsewhere on the board
/ALU/RA5: U13.3 (A2); also elsewhere on the board
/ALU/RA6: U13.14 (A3); also elsewhere on the board
/ALU/RA7: U13.12 (A4); also elsewhere on the board
/ALU/RB0: U30.5; also elsewhere on the board
/ALU/RB1: U30.2; also elsewhere on the board
/ALU/RB2: U30.13; also elsewhere on the board
/ALU/RB3: U30.10; also elsewhere on the board
/ALU/RB4: U31.5; also elsewhere on the board
/ALU/RB5: U31.2; also elsewhere on the board
/ALU/RB6: U31.13; also elsewhere on the board
/ALU/RB7: U31.10; also elsewhere on the board
/ALU/S0: D52.2 (A), U32.3, U33.4 (S1), U34.18 (B0)
/ALU/S1: D53.2 (A), U32.2, U33.1 (S2), U34.17 (B1)
/ALU/S2: D54.2 (A), U32.5, U33.13 (S3), U34.16 (B2)
/ALU/S3: D55.2 (A), U32.4, U33.10 (S4), U34.15 (B3)
/ALU/S4: D56.2 (A), U13.4 (S1), U32.11, U34.14 (B4)
/ALU/S5: D57.2 (A), U13.1 (S2), U32.12, U34.13 (B5)
/ALU/S6: D58.2 (A), U13.13 (S3), U32.9, U34.12 (B6)
/ALU/ZH_FLAG: U32.13; also elsewhere on the board
/ALU/ZL_FLAG: U32.1; also elsewhere on the board
/ALU/~EO: D78.1 (K), U34.19 (CE); also elsewhere on the board
GND: R26.2, R27.2, R28.2, RN8.1 (common), U13.8 (GND), U30.7 (GND), U31.7 (GND), U32.7 (VSS), U33.8 (GND), U34.1 (A->B), U34.10 (GND); also elsewhere on the board
unnamed: D52.1 (K), RN8.9 (R8)
unnamed: D53.1 (K), RN8.8 (R7)
unnamed: D54.1 (K), RN8.7 (R6)
unnamed: D55.1 (K), RN8.6 (R5)
unnamed: D56.1 (K), RN8.5 (R4)
unnamed: D57.1 (K), RN8.4 (R3)
unnamed: D58.1 (K), RN8.3 (R2)
unnamed: D59.1 (K), RN8.2 (R1)
unnamed: D78.2 (A), R11.1
unnamed: D93.1 (K), R26.1
unnamed: D94.1 (K), R27.1
unnamed: D95.1 (K), R28.1
unnamed: U13.6 (B1), U31.6
unnamed: U13.2 (B2), U31.3
unnamed: U13.15 (B3), U31.11
unnamed: U13.11 (B4), U31.8
unnamed: U13.7 (C0), U33.9 (C4)
unnamed: U30.6, U33.6 (B1)
unnamed: U30.3, U33.2 (B2)
unnamed: U30.11, U33.15 (B3)
unnamed: U30.8, U33.11 (B4)
