coaic/Minimal-UART-Computer-3/KiCAD10/8-Bit CPU 32k.kicad_pcb

## KiCad design KiCAD10/8-Bit CPU 32k.kicad_pcb (continued)

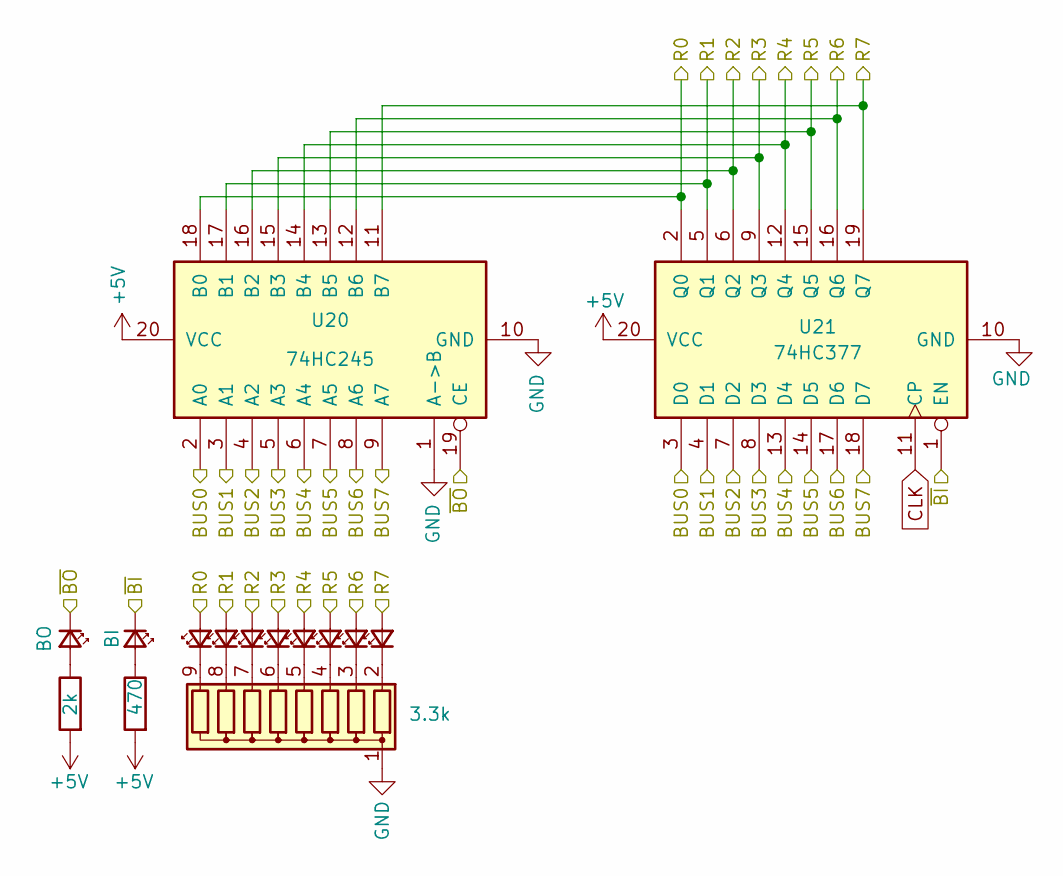
[picture p7: schematic RegB.kicad_sch, B Register]

Parts:
D44, D45, D46, D47, D48, D49, D50, D51: LED_Small; LED_D5.0mm
D76: BI; LED_D5.0mm
D77: BO; LED_D5.0mm
R9: 470; R_Axial_DIN0207_L6.3mm_D2.5mm_P7.62mm_Horizontal
R10: 2k; R_Axial_DIN0207_L6.3mm_D2.5mm_P7.62mm_Horizontal
RN7: 3.3k; R_Array_SIP9
U20: 74HC245; DIP-20_W7.62mm
U21: 74HC377; DIP-20_W7.62mm

Connections:
+5V: R9.2, R10.2, U20.20 (VCC), U21.20 (VCC); also elsewhere on the board
/ALU/BUS0: U20.2 (A0), U21.3 (D0); also elsewhere on the board
/ALU/BUS1: U20.3 (A1), U21.4 (D1); also elsewhere on the board
/ALU/BUS2: U20.4 (A2), U21.7 (D2); also elsewhere on the board
/ALU/BUS3: U20.5 (A3), U21.8 (D3); also elsewhere on the board
/ALU/BUS4: U20.6 (A4), U21.13 (D4); also elsewhere on the board
/ALU/BUS5: U20.7 (A5), U21.14 (D5); also elsewhere on the board
/ALU/BUS6: U20.8 (A6), U21.17 (D6); also elsewhere on the board
/ALU/BUS7: U20.9 (A7), U21.18 (D7); also elsewhere on the board
/ALU/RB0: D44.2 (A), U20.18 (B0), U21.2 (Q0); also elsewhere on the board
/ALU/RB1: D45.2 (A), U20.17 (B1), U21.5 (Q1); also elsewhere on the board
/ALU/RB2: D46.2 (A), U20.16 (B2), U21.6 (Q2); also elsewhere on the board
/ALU/RB3: D47.2 (A), U20.15 (B3), U21.9 (Q3); also elsewhere on the board
/ALU/RB4: D48.2 (A), U20.14 (B4), U21.12 (Q4); also elsewhere on the board
/ALU/RB5: D49.2 (A), U20.13 (B5), U21.15 (Q5); also elsewhere on the board
/ALU/RB6: D50.2 (A), U20.12 (B6), U21.16 (Q6); also elsewhere on the board
/ALU/RB7: D51.2 (A), U20.11 (B7), U21.19 (Q7); also elsewhere on the board
/Control Logic/~BI: D76.1 (K), U21.1 (EN); also elsewhere on the board
/Control Logic/~BO: D77.1 (K), U20.19 (CE); also elsewhere on the board
CLK: U21.11 (CP); also elsewhere on the board
GND: RN7.1 (common), U20.1 (A->B), U20.10 (GND), U21.10 (GND); also elsewhere on the board
unnamed: D44.1 (K), RN7.9 (R8)
unnamed: D45.1 (K), RN7.8 (R7)
unnamed: D46.1 (K), RN7.7 (R6)
unnamed: D47.1 (K), RN7.6 (R5)
unnamed: D48.1 (K), RN7.5 (R4)
unnamed: D49.1 (K), RN7.4 (R3)
unnamed: D50.1 (K), RN7.3 (R2)
unnamed: D51.1 (K), RN7.2 (R1)
unnamed: D76.2 (A), R9.1
unnamed: D77.2 (A), R10.1

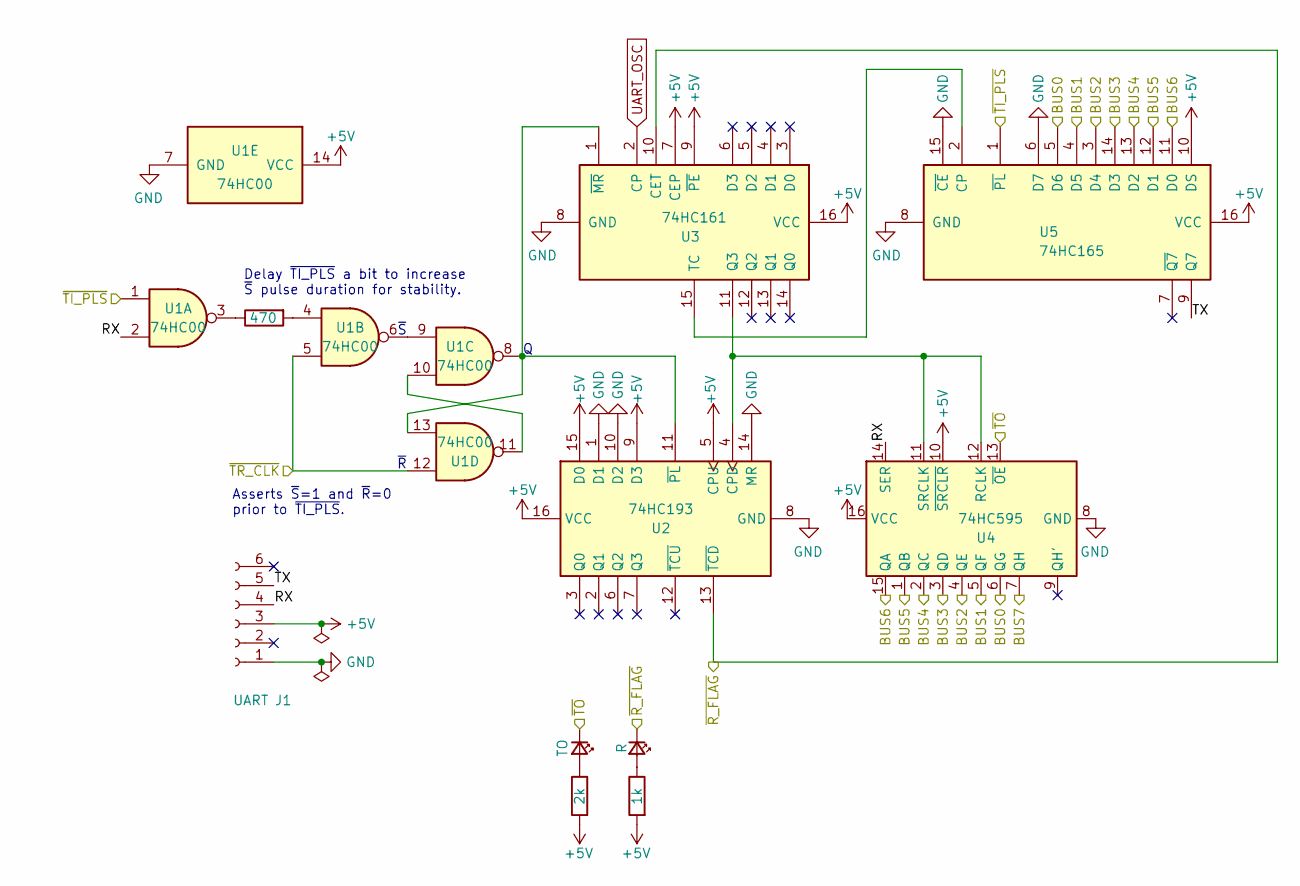
[picture p8: schematic UART_RX.kicad_sch, UART]

Parts:
D80: TO; LED_D5.0mm
D97: R; LED_D5.0mm
J1: UART; PinSocket_1x06_P2.54mm_Vertical
R13: 2k; R_Axial_DIN0207_L6.3mm_D2.5mm_P7.62mm_Horizontal
R29: 470; R_Axial_DIN0207_L6.3mm_D2.5mm_P7.62mm_Horizontal
R30: 1k; R_Axial_DIN0207_L6.3mm_D2.5mm_P7.62mm_Horizontal
U1: 74HC00; DIP-14_W7.62mm
U2: 74HC193; DIP-16_W7.62mm
U3: 74HC161; DIP-16_W7.62mm
U4: 74HC595; DIP-16_W7.62mm
U5: 74HC165; DIP-16_W7.62mm

Connections:
+5V: J1.3, R13.2, R30.2, U1.14 (VCC), U2.5 (CPU), U2.9 (D3), U2.15 (D0), U2.16 (VCC), U3.7 (CEP), U3.9 (~PE), U3.16 (VCC), U4.10 (~SRCLR), U4.16 (VCC), U5.10 (DS), U5.16 (VCC); also elsewhere on the board
/ALU/BUS0: U4.6 (QG), U5.5 (D6); also elsewhere on the board
/ALU/BUS1: U4.5 (QF), U5.4 (D5); also elsewhere on the board
/ALU/BUS2: U4.4 (QE), U5.3 (D4); also elsewhere on the board
/ALU/BUS3: U4.3 (QD), U5.14 (D3); also elsewhere on the board
/ALU/BUS4: U4.2 (QC), U5.13 (D2); also elsewhere on the board
/ALU/BUS5: U4.1 (QB), U5.12 (D1); also elsewhere on the board
/ALU/BUS6: U4.15 (QA), U5.11 (D0); also elsewhere on the board
/ALU/BUS7: U4.7 (QH); also elsewhere on the board
/Control Logic/~R_FLAG: D97.1 (K), U2.13 (~TCD), U3.10 (CET); also elsewhere on the board
/Control Logic/~TI_PLS: U1.1, U5.1 (~PL); also elsewhere on the board
/Control Logic/~TO: D80.1 (K), U4.13 (~OE); also elsewhere on the board
/Control Logic/~TR_PLS: U1.5, U1.12; also elsewhere on the board
/UART/RX: J1.4, U1.2, U4.14 (SER)
/UART/TX: J1.5, U5.9 (Q7)
GND: J1.1, U1.7 (GND), U2.1 (D1), U2.8 (GND), U2.10 (D2), U2.14 (MR), U3.8 (GND), U4.8 (GND), U5.6 (D7), U5.8 (GND), U5.15 (~CE); also elsewhere on the board
unnamed: D80.2 (A), R13.1
unnamed: D97.2 (A), R30.1
unnamed: R29.1, U1.3
unnamed: R29.2, U1.4
unnamed: U1.6, U1.9
unnamed: U1.10, U1.11
unnamed: U2.4 (CPD), U3.11 (Q3), U4.11 (SRCLK), U4.12 (RCLK)
unnamed: U1.8, U1.13, U2.11 (~PL), U3.1 (~MR)
unnamed: U3.15 (TC), U5.2 (CP)
UART_OSC: U3.2 (CP); also elsewhere on the board

Notes on the sheet:
Delay ~{TI_PLS} a bit to increase ~{S} pulse duration for stability.
Asserts ~{S}=1 and ~{R}=0 prior to ~{TI_PLS}.
~{S}
~{R}

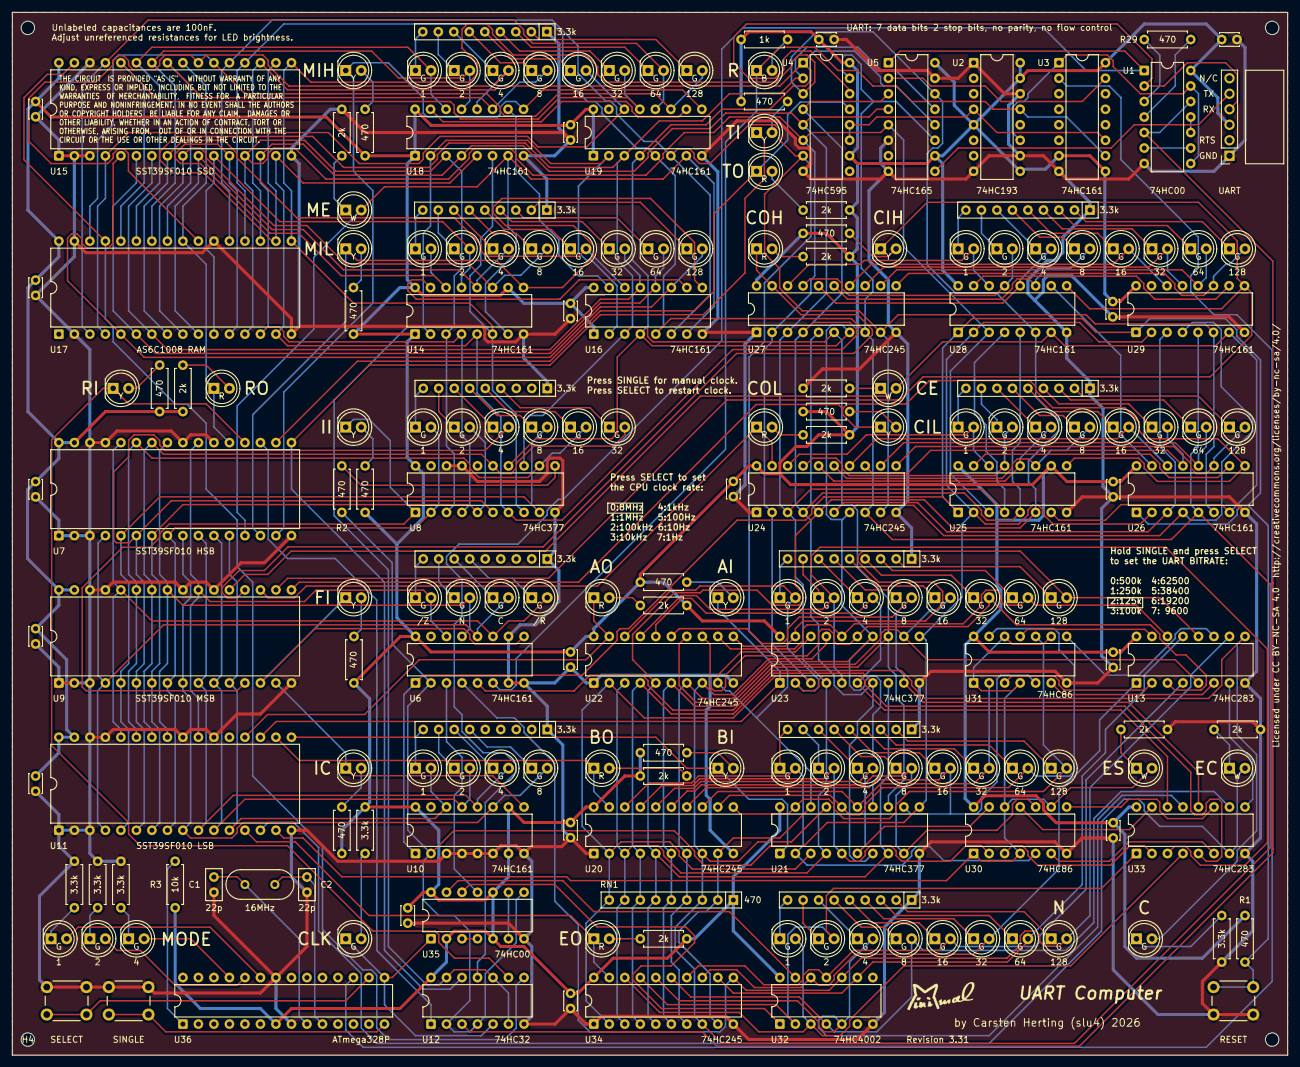
[picture p9: board 8-Bit CPU 32k.kicad_pcb from above]

Board: 2 copper layers, 208.9 x 170.8 mm, 206 parts (0 on the bottom side), 249 nets.
