coaic/Minimal-UART-Computer-3/(commit log)

2026-06-27 Add KiCAD10 working copy of the CPU project
    Duplicate of KiCAD9/ as a side-by-side working copy for KiCad 10.
    The KiCad 9 -> 10 schematic conversion is one-way, so KiCAD9/ is kept
    pristine as a fallback and all KiCad 10 work happens here. Local/auto-
    generated junk (lock files, .history, .DS_Store) was excluded from the copy.
    [8-Bit CPU 32k.dsn, 8-Bit CPU 32k.kicad_pcb, 8-Bit CPU 32k.kicad_sch, 8-Bit CPU 32k.sch, ALU.kicad_sch, ALU.sch, IR.kicad_sch, IR.sch]
2026-06-27 Add .gitignore and untrack KiCad local/cache files
    Ignore macOS .DS_Store and KiCad's local/auto-generated files (lock
    files, .kicad_prl, *-backups/, fp-info-cache, .history/, autosave).
    Remove three such files that were already tracked; they stay on disk
    but will no longer be committed.
2026-06-27 Add BOM.csv generated from the KiCad netlist
    Grouped bill of materials (83 parts, 26 lines) extracted from
    "KiCAD9/8-Bit CPU 32k.net": qty, value, reference designators,
    footprint, a suggested through-hole MPN, and a critical/jellybean
    sourcing note. Covers the core UART machine (UART + 2x16 expansion
    header); VGA/PS-2 connectors are not included and must be added if
    those options are populated.
    [BOM.csv]
2026-06-27 Regenerate BOM.csv from the PCB (was wrong — built from stale netlist)
    The previous BOM.csv was parsed from "8-Bit CPU 32k.net", which is an
    out-of-date netlist describing an older revision: it omitted the ~98
    front-panel LEDs and most resistors, and listed the wrong RAM (CY62256)
    and IC mix. Regenerate from "8-Bit CPU 32k.kicad_pcb" — the source the
    Gerbers were exported from — giving the real 207-component board:
    98x 5mm LED, 11x SIP-9 arrays, 32 discrete R, 20 C, 16 74HCxx,
    4x SST39SF010 flash, AS6C1008 SRAM, on-board ATmega328P + 16MHz xtal,
    3 switches, UART socket, 4x M2 holes.
    [BOM.csv]
2026-06-27 Document BOM source and front-panel LED colour scheme in CLAUDE.md
    Add a "Bill of materials and front-panel LEDs" section: note BOM.csv is
    generated from the PCB (not the stale .net), record the ~98 5mm LEDs and
    a recommended per-group colour scheme (control signals / data bus /
    address bus / registers / flags+clock), and flag the order-sensitive
    parts (SIP-9 arrays, SST39SF010 flash, AS6C1008 RAM, on-board ATmega328P).
2026-06-27 Convert KiCAD10 project to KiCad 10 format
    Finish the KiCad 9 -> 10 conversion of the working copy:
    - Schematic (root + PC/RegA/IR/RAM/ALU/RegB/UART_RX) saved by the
    KiCad 10 Schematic Editor (generator_version 10.0).
    - Board upgraded with `kicad-cli pcb upgrade --force` (generator_version
    10.0, format 20260206).
    All active design files are now KiCad 10. The pre-conversion KiCad 9
    state remains in commit 1809bc2 for diff/revert; KiCAD9/ is untouched.
    [8-Bit CPU 32k.kicad_pcb, 8-Bit CPU 32k.kicad_sch, ALU.kicad_sch, IR.kicad_sch, PC.kicad_sch, RAM.kicad_sch, RegA.kicad_sch, RegB.kicad_sch]
2026-06-27 Ignore KiCad DRC/ERC .rpt reports
    Generated reports (e.g. KiCAD10/DRC.rpt) are build artifacts, not design
    source — keep them out of git.
2026-06-28 Add orderable MPNs for flash/RAM/MCU and document chip programming
    - BOM.csv: add MPN column; specify PDIP package variants
    (SST39SF010A-70-4C-PHE, AS6C1008-55PCN, ATMEGA328P-PU) so the
    orderable part is unambiguous from the DIP-32/DIP-28 footprints.
    - Store matching MPN properties on the U7/U9/U11/U15/U17/U36 symbols
    in the KiCad 10 schematic so they survive BOM regeneration.
    - CLAUDE.md: document chip identification by silkscreen U-number,
    the package-suffix gotcha, and that U36 (ATmega) has no on-board
    ISP path and must be programmed off-board (DIP-socket Uno / ZIF).
    [BOM.csv, IR.kicad_sch, RAM.kicad_sch]
2026-07-19 Capture as-built LED colours as schematic Color field
    Prepping the BOM/PCB for a prototype fab run: the front-panel LED
    colour was only recorded per-footprint on the PCB (the Description
    field, e.g. "LED GREEN, 2000mcd, 60°") and so never reached the
    schematic-generated BOM. Copy that colour onto all 98 LED symbols as
    a hidden `Color` property, matched by reference designator, so it
    travels with the BOM the same way `MPN` does (add `Color` to the BOM
    export field list). As-built distribution: Green 75, Yellow 11,
    Red 7, White 4, Blue 1.
    Source of truth for colour is now the schematic `Color` field; the
    PCB footprint `Description` is the independent original and KiCad does
    not auto-sync the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
    [8-Bit CPU 32k.kicad_sch, ALU.kicad_sch, IR.kicad_sch, PC.kicad_sch, RAM.kicad_sch, RegA.kicad_sch, RegB.kicad_sch, UART_RX.kicad_sch]
2026-07-19 Ignore KiCad BOM/netlist CSV exports in project folders
    The canonical BOM is the root BOM.csv; KiCad drops throwaway CSV
    exports (e.g. 'KiCAD10/8-Bit CPU 32k.csv') next to the project files
    when you Generate BOM. Ignore those so they don't get committed.
2026-07-19 Normalise D1-D3 LED value case (LED_small -> LED_Small)
    D1-D3 carried Value 'LED_small' (lowercase s) while every other
    generic LED used 'LED_Small'. BOM grouping is case-sensitive, so the
    typo split D1-D3 into their own line despite being the identical part.
    Normalise the three so they merge with the main green LED group.
    [IR.kicad_sch]
2026-07-19 Tag red LEDs with Element14 order code 703-0100
    Add MPN 703-0100 to the 7 red front-panel LEDs (D66 AO, D77 BO,
    D78 EO, D80 TO, D81 COH, D83 COL, D99 RO) for the Element14 order.
    [ALU.kicad_sch, PC.kicad_sch, RAM.kicad_sch, RegA.kicad_sch, RegB.kicad_sch, UART_RX.kicad_sch]
2026-07-19 Move LED Element14 code from MPN to Supplier Ref field
    Element14/Farnell order codes are distributor codes, not manufacturer
    part numbers, so keep them out of MPN (which holds manufacturer PNs
    like SST39SF010A-70-4C-PHE for the chips). Migrate the red LEDs'
    703-0100 into a dedicated 'Supplier Ref' property and document the
    MPN vs Supplier Ref convention in CLAUDE.md.
    [ALU.kicad_sch, PC.kicad_sch, RAM.kicad_sch, RegA.kicad_sch, RegB.kicad_sch, UART_RX.kicad_sch]
2026-07-19 Tag green LEDs with Kingbright MPN L-53SGC
    Green LED part is Kingbright L-53SGC — a manufacturer part number, so
    it goes in MPN (all 75 green LEDs), unlike the red LEDs' Farnell code
    which lives in Supplier Ref. Update the LED sourcing table in CLAUDE.md.
    [ALU.kicad_sch, IR.kicad_sch, PC.kicad_sch, RAM.kicad_sch, RegA.kicad_sch, RegB.kicad_sch]
2026-07-19 Standardise LEDs on Supplier Ref (Element14-only sourcing)
    Only Element14 is used for LEDs, so identify every LED by its
    Element14 Supplier Ref and carry no MPN on LEDs. Move the green LEDs'
    L-53SGC from MPN to Supplier Ref (red 703-0100 already there). MPN
    stays reserved for the socketed chips (manufacturer parts). Update the
    LED sourcing table in CLAUDE.md.
    [ALU.kicad_sch, IR.kicad_sch, PC.kicad_sch, RAM.kicad_sch, RegA.kicad_sch, RegB.kicad_sch]
2026-07-19 Tag yellow LEDs with Element14 Supplier Ref MCL053YD
    Add Supplier Ref MCL053YD to the 11 yellow front-panel LEDs and update
    the LED sourcing table in CLAUDE.md. White and blue still uncoded.
    [IR.kicad_sch, PC.kicad_sch, RAM.kicad_sch, RegA.kicad_sch, RegB.kicad_sch]
2026-07-19 Tag white LEDs with Element14 Supplier Ref C512A-WNN-CZ0B0151
    Add Supplier Ref C512A-WNN-CZ0B0151 to the 4 white front-panel LEDs
    and update the LED sourcing table in CLAUDE.md. Only blue left.
    [ALU.kicad_sch, PC.kicad_sch, RAM.kicad_sch]
2026-07-19 Tag blue LED with Element14 Supplier Ref C503B-BCS-CV0Z0461
    Add Supplier Ref C503B-BCS-CV0Z0461 to the single blue LED (D97). All
    98 front-panel LEDs are now coded for Element14; update the CLAUDE.md
    sourcing table.
    [UART_RX.kicad_sch]
2026-07-19 Document per-colour LED drive currents from netlist trace
    Traced a fresh kicad-cli netlist: the 70 bus/register LEDs are green
    on the RN1-RN11 3.3k arrays (~0.85mA), while the 28 named control/
    flag/clock LEDs each have a discrete resistor valued by colour
    (yellow 470R, blue 1k, red/white 2k, green 3.3k) so the high-Vf blue
    and white are not starved. Record the mapping and retuning notes in
    CLAUDE.md.
2026-09-13 Add Color, MPN and Supplier Ref to schematic BOM export fields
    Color and Supplier Ref group rows so LEDs split per colour/order code;
    MPN was already listed but hidden.
2026-09-13 Add submit-ready Element14 order list for the full board
    36 lines with verified numeric Element14 order codes covering every
    orderable BOM line plus DIP sockets. TI PDIP for all 74HC logic,
    Bourns 4609X bussed SIP-9 arrays, exact 2.0k MF25 resistors, 18pF
    HC-49/4H crystal. Includes LED spares and one spare flash/DIP-32.
    [element14_order.csv]
2026-09-13 Fix red LED Supplier Ref: use Element14 order code 2112111
    703-0100 was the Multicomp MPN, not an Element14 order code. All 7
    red LEDs (AO BO EO TO COH COL RO) now carry the numeric code, and
    the CLAUDE.md sourcing table matches.
    [ALU.kicad_sch, PC.kicad_sch, RAM.kicad_sch, RegA.kicad_sch, RegB.kicad_sch, UART_RX.kicad_sch]
2026-09-13 Rework order list around Element14 AU availability (Sep 2026)
    Ten lines failed the AU BOM tool: all TI PDIP logic plus the EOL
    SST39SF010A flash. Substitutes: Nexperia DIP codes for HC32/86/165/
    161/245/377, HCT193 (flagged), and SST39SF020A-70-4C-PHE for the
    flash - safe because the PCB grounds pins 1/2/30 (A18/A16/A17),
    verified against a fresh netlist. 74HC4002 and 74HC283 have no DIP
    at Element14 and move to external_order.csv with fallback lines.
    [element14_order.csv, external_order.csv]
2026-09-13 Add minimal code+qty CSV for the Element14 upload tool
    The BOM uploader hung on the reworked 4-column file (CRLF + minimal
    quoting are valid CSV, but the tool gave no error). This stripped
    version has no quotes or in-field commas; the full element14_order.csv
    remains the annotated reference.
    [element14_upload_simple.csv]
2026-09-13 Restore original CSV formatting on the order list
    Back to LF line endings with every Line Note quoted - the exact
    style of the file the Element14 BOM tool accepted first time.
    Content (34 lines with substitutions) unchanged.
    [element14_order.csv]
