coaic/Minimal-UART-Computer-3/(notices)

Notices in the files:
KiCAD10/UART_TX.kicad_sch:
creativecommons.org/licenses/by-nc-sa/4.0
This work is licensed under CC BY-NC-SA 4.0
KiCAD10/PC.sch:
creativecommons.org/licenses/by-nc-sa/3.0/deed.en
License: CC BY-NC-SA 3.0
KiCAD10/8-Bit CPU 32k.kicad_pcb:
Licensed under CC BY-NC-SA 4.0 http://creativecommons.org/licenses/by-nc-sa/4.0
